l7ssha/prac_inz/document/praca_v3.tex

\documentclass[12pt,a4paper]{article}

\usepackage{minted}
\usepackage[T1]{fontenc}
\usepackage{url}
\usepackage{color,soul}
\usepackage{caption}
\usepackage{biblatex}
\usepackage{float}
\usepackage{geometry}
\usepackage{times}
\usepackage{titlesec}
\usepackage{ragged2e}
\usepackage{fancyhdr}
\usepackage{pdfpages}
\usepackage{graphicx}
\usepackage{indentfirst}

\graphicspath{ {./images/} }

\AddToHook{cmd/section/before}{\clearpage}

\titleformat*{\section}{\fontsize{14}{10}\bfseries\selectfont\MakeUppercase}
\titleformat*{\subsection}{\fontsize{13}{10}\bfseries\selectfont}

\geometry{
    a4paper,
    left=35mm,
    right=25mm,
    top=25mm,
    bottom=30mm,
}

\pagestyle{fancyplain}
\fancyhf{}
\fancyfoot[R]{\thepage}
\renewcommand{\headrulewidth}{0pt}

\renewcommand{\baselinestretch}{1.5}

\captionsetup[table]{name=Tabela}
\captionsetup[figure]{name=Obrazek}
\renewcommand*\contentsname{Spis treści}
\renewcommand{\listtablename}{Spis tabel}
\renewcommand{\listfigurename}{Spis obrazków, fotografii}

\newfloat{code}{h}{loa}
\captionsetup[code]{name=Program}

\makeatletter
\renewcommand\listoffigures{
    \subsection*{\listfigurename
        \@mkboth{
           \MakeUppercase\listfigurename}{\MakeUppercase\listfigurename}}
    \@starttoc{lof}
}
\renewcommand\listoftables{
    \subsection*{\listtablename
        \@mkboth{
           \listtablename}{\listtablename}}
    \@starttoc{lot}
}
\renewcommand*{\listof}[2]{%
  \@ifundefined{ext@#1}{\float@error{#1}}{%
    \@namedef{l@#1}{\@dottedtocline{1}{1.5em}{2.3em}}%
    \subsection*{#2}% \float@listhead{#2}
    \begingroup\setlength{\parskip}{\z@}%
      \@starttoc{\@nameuse{ext@#1}}%
    \endgroup}
}
\makeatother

\addbibresource{sources.bib}

\title{Konstrukcja stacji pogodowej opartej na mikrokontrolerze ESP32 z interfejsem użytkownika oraz API REST}
\author{Szymon Uglis}

\begin{document}

\justifying

\nocite{*}

\begin{titlepage}
    \includepdf{titlepage}
\end{titlepage}

\tableofcontents{}
\pagebreak

\section{Wstęp}

\subsection{Wprowadzenie}
Dzięki szerokiemu dostępowi do internetu mamy łatwy dostęp do danych pogodowych aktualnych jak i historycznych z całego świata. Istnieje wiele serwisów, programów telewizyjnych, które aktualne dane pogodowe, prognozy pogody prezentują nam w przystępny sposób. Problemem z poleganiem na danych pogodowych z popularnych serwisów jest relatywnie niska dokładność aktualnych warunków pogodowych jak i prognoz pogody. Bowiem serwisy te nie mogą mieć stacji pogodowowych rozstawionych co na przykład kilometr, aby dokładność dla każdego potencjalnego zainteresowana była wysoka. Dlatego polega się w dużym stopniu na ogólnych danych z kilku, bądź kilkunastu stacji w danym regionie, aby wykonać ekstrapolację dla aktualnych warunków pogodowych dla całego regionu. Serwisy udostępniające dane pogodowe dla lokalizacji są tylko przybliżeniem faktycznych stanu jaki znajduje sie w danym miejscu.

\subsection{Cel projektu oraz opis tworzonego rozwiązania}

Celem projektu jest zbadanie przydatności modułu ESP32 oraz kompatybilnych komponentów do celów kolekcji danych pogodowych. Rezultatem będzie utworzenie urządzenia opartego na systemie wbudowanym pozwalającym na wielofunkcyjny pomiar parametrów pogodowych oraz udostępnianie ich za pomocą witryny www.

Urządzenie, będzie udostępniało również interfejs programistyczny API REST, które będzie umożliwiało integrację oraz dalszy rozwój projektu (np. integracja z systemem home assistant czy innymi urządzeniami Internetu rzeczy (IoT)).

\subsubsection{Funkcje urządzenia}
\begin{itemize}
    \item Pomiar oraz kalkulacja danych pogodowych na podstawie danych wejściowych z czujników
    \item Udostępnienie i agregacja danych na stronie www
    \item Udostępnienie interfejsu programistycznego REST
    \item Możliwość zmiany parametrów odczytów sensorów
\end{itemize}

\subsubsection{Dostęp zdalny do urządzenia}

Urządzenia ze świata IoT są najczęściej urządzeniami lokalnymi - bez publicznego adresu IP i/lub bez możliwości zdalnego dostępu. Ze względu na niską moc takich urządzeń, ubogie oprogramowanie, w które takie urządzenia są wyposażone bardzo często nie zawierają wielu ważnych zabezpieczeń przeciwko potencjalnym atakom. Dodatkowo dane udostępnianie przez urządzenia IoT z bardzo często są danymi które nie powinny być dostępne publicznie (np. dane o obecności osób w pomieszczeniu lub czy zamek od drzmi jest zamknięty).

Zalecanym jest, aby dostęp do urządzeń IoT był całkowicie lokalny (najlepiej dodatkowo zablokować dostęp do internetu dla tych urządzeń), a zbieraniem i udostępnianiem danych publicznych było realizowane przez oprogramowanie dedykowane do tego celu. Aby umożliwić dostęp do danych zbieranych przez tworzone urządzenie, oprogramowanie będzie implementować możliwość wysyki danych do publicznego brokera MQTT. Dane zaagregowane przez MQTT mogą być dalej bezpiecznie filtrowane, przetwarzane i udostępniane publicznie przez oprogramowanie do tego przystosowane.

\section{Konfiguracja sprzętowa}

\begin{itemize}
    \item Mikrokontroler - ESP-WROOM-32
    \item Czujnik natężenia światła - TSL25911
    \item Czujnik temperatury i wilgotności powietrza - DHT22
    \item Czujnik ciśnienia oraz temperatury - DPS310
    \item Czujnik światła ultrafioletowego - LTR390
\end{itemize}

\begin{figure}[H]
    \centering
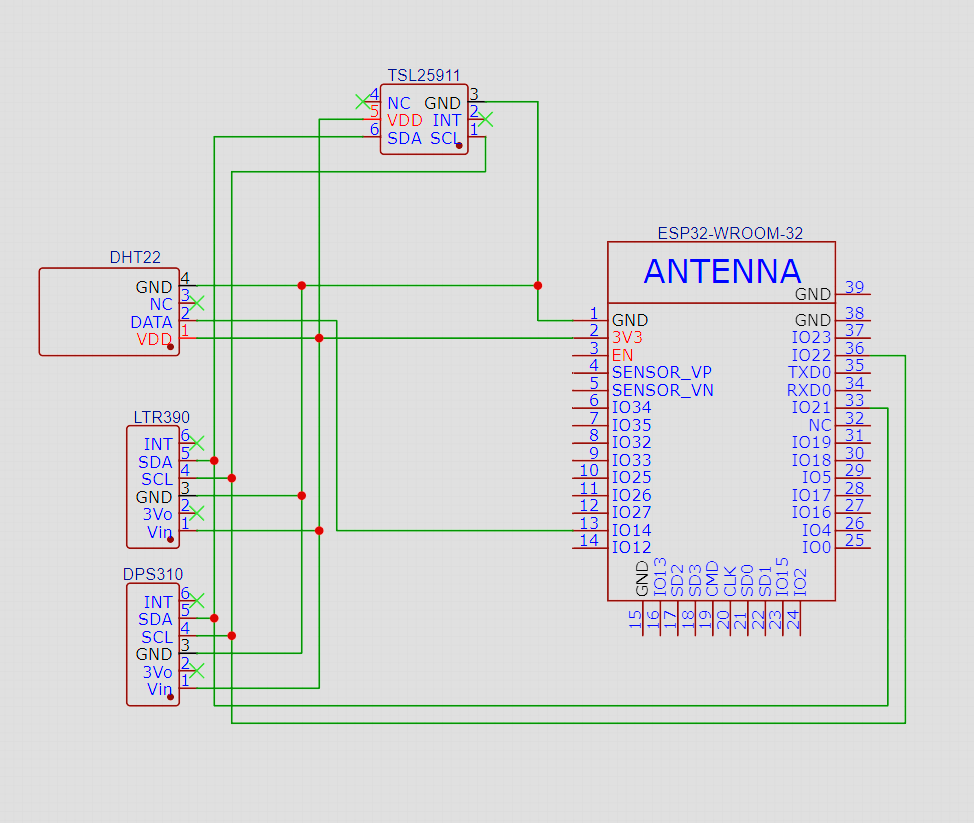
[picture p1: document/images/device-schematic.png]
    
    \caption{Schemat urządzenia}
    \label{device-schematic}
\end{figure}

\begin{figure}[H]
    \centering
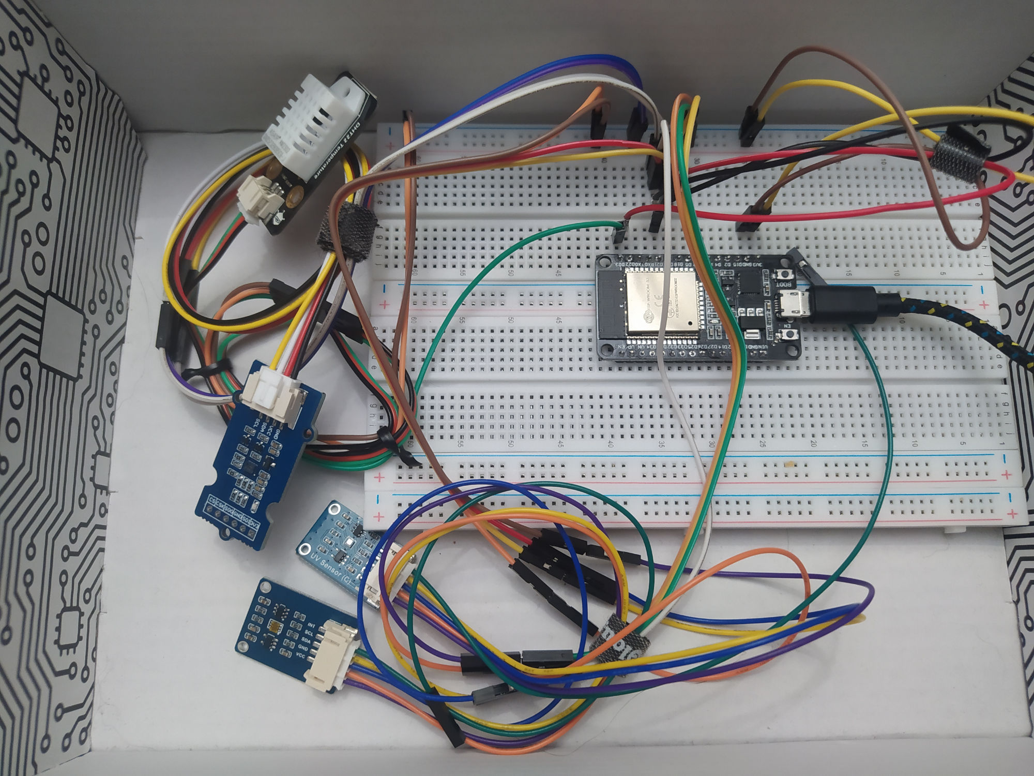
[picture p2: document/images/device-image.jpg]
    
    \caption{Fotografia prototypu urządzenia}
    \label{device-image}
\end{figure}

\subsection{ESP-WROOM-32}
ESP-WROOM-32 (albo ESP32-WROOM-32) to mikrokontroler ze zintegrowanymi interfejsami WIFI oraz bluetooth. Nadaje się do szerokiej gamy zastosowań: od kontrolera czujników z niskim poborem energii do zaawansowanych zadań enkodowania sygnałów głosowych czy muzyki. Moduły bazujące na rdzeniach ESP32 zyskały popularność ze wzlędu na zaintegrowaną obsługę WIFI,  wielu intefejsom oraz niskiemu kosztowi.

Mikrokontroler znajdzie zastosowanie w prostych jak i bardziej skomplikowanych projektach, dzięki dwóm rdzenion, szerokich możliwościach podłączenia urządzeń peryferyjnych (wsparcie dla: I2C, UART, SPI oraz inne).

ESP-WROOM-32 składa się z mikrokontrolera ESP32-D0WDQ6 posiadającego dwa rdzenie, które pozwają na prace z częstotliwościami zegara od 80MHz do 240 MHz. Procesor również posiada koprocesor o niskim poborze mocy, który może zostać użyty zamiast głównych rdzeni w przypadku kiedy nie jest potrzebna duża moc obliczeniowa.

Integracja WIFI, Bluetooth i Bluetooth LE do mikrokontrolera pozwala na rozszerzenie możliwych zastosowań, gdzie nie jest możliwe podłączenie do sieci w konwencjonalny sposób za pomocą kabla. Komunikacja bezprzewodowa również umożliwia całkowicie zdalne zastosowania z wykorzystaniem akumulatorów oraz paneli słonecznych do zasilania mikrokontrolera.

\subsubsection{Specyfikacja ESP-WROOM-32}

\begin{table}[H]
    \centering
    \begin{tabular}{|l|l|}
        \hline
        Element & Specyfikacja \\
        \hline
        Procesor & 2 rdzenie (80-240MHz) \\
        \hline
        WIFI & 802.11 b/g/n (802.11n: przepustowość 150 Mbps) \\
        \hline
        Bluetooth & Bluetooth v4.2 i Bluetooth LE \\
        \hline
        Pamięć SPI Flash & 4MB \\
        \hline
        Napięcie zasilania & 3.0 V - 3.6 V \\
        \hline
        Zużycie prądu & Średnie: 80 mA \\
        \hline
    \end{tabular}
    \caption{Najważniejsze specyfikacje ESP-WROOM-32}
    \label{esp32-spec}
\end{table}

Do realizacji projektu została wybrany mikrokontroler ESP-WROOM-32 ze względu na:
\begin{itemize}
    \item bogate możliwości podłączenia urządzeń peryferyjnych
    \item wbudowane wsparcie połączeń WIFI
    \item dużą ilość pamięci flash
    \item niewielką cenę w porównaniu do oferowanych specyfikacji
    \item łatwą dostępność
\end{itemize}

\noindent Potencjalnymi alternatywami, które nie zostały wybrane do realizacji projektu są:
\begin{itemize}
    \item Arduino Uno R3 (brak wbudowanej obsługi połączeń sieciowych)
    \item ESP8266 (wolniejszy procesor, mniejsza ilość pamięci flash, mniejsza ilość wyprowadzeń do podłączenia urządzeń peryferyjnych)
    \item Olimex ESP32-POE\cite{olimex-esp32poe} (wbudowana obsługa połączenie przewodowego ethernet, mniejsza ilość wyprowadzeń do podłączenia urządzeń peryferyjnych)
    \item LILYGO T-SIM7000G\cite{lilygo-esp32lte} (wbudowana obsługa LTE, mniejsza ilość wyprowadzeń do podłączenia urządzeń peryferyjnych, wysoka cena)
\end{itemize}

\noindent W finalnym produkcie w zależności od przeznaczenia użycie łączności bezprzewodowej może być niemożliwe (daleka odległość od punktu dostępowego WIFI, duża ilość przeszkód). Użycie innych wersji ESP32 z wbudowaną obsługą przewodowego połączenia sieciowego lub możliwością połączenia do sieci przez LTE, może być wymagane - jednak w ramach realizacji zakresu projektu wybór padł na łatwiej dostępny moduł z łącznością bezprzewodową WIFI.  

\subsection{Czujnik natężenia światła - TSL25911}

TSL25911 to czujnik światła z odpowiedzią podobną do ludzkiego oka. Posiada czułość 188 uLux oraz zakres dynamiczny 1 do 600,000,000. W porównaniu do innych tańszych rozwiązań bazujących na fotokomórkach CdS, daje o wiele bardziej precyzyjne rezultaty, z możliwością zmiany czułości i rozdzielczości w locie.

\subsubsection{Specyfikacja TSL25911}
\begin{table}[H]
    \centering
    \begin{tabular}{|l|l|}
        \hline
        Element & Specyfikacja \\
        \hline
        Rozdzielczość dynamiczna & 1 do 600,000,000 \\
        \hline
        Zakres pomiaru & 188 uLux - 88,000 Lux \\
        \hline
        Zakres temperatury pracy & -30 - 80 °C \\
        \hline
        Interfejs & I2C (adres: 0x29 i 0x28)\\
        \hline
    \end{tabular}
    \caption{Specyfikacja TSL25911}
    \label{tsl25911-spec}
\end{table}

\subsubsection{Przykładowy program testu czujnika TSL25911}

\begin{code}[H]
\inputminted[frame=lines,baselinestretch=1,breaklines,linenos,xleftmargin=1.5em]{c}{../proj/tsl2591-test/tsl2591-test.ino}

\caption{Program testu czujnika TSL25911}
\end{code}

\subsubsection{Test czujnika TSL25911}
\begin{figure}[H]
    \centering
    
    \caption{Rezultat testu czujnika TSL25911}
\end{figure}

\subsection{Czujnik temperatury i wilgotności powietrza - DHT22}

Czujnik DHT22 składaja się z dwóch części: pojemnościowego czujnika wilgotności i termistora. Wewnątrz znajduje się również bardzo prosty chip, który dokonuje konwersji sygnału analogowego na cyfrowy i wysyła sygnał cyfrowy z temperaturą i wilgotnością. Sygnał cyfrowy jest łatwy do odczytania za pomocą dowolnego mikrokontrolera.

Czujnik ten cechuje sie bardzo niską ceną oraz bardzo dużą dokładnością w stosunku do ceny.

Potencjalnymi alternatywami, które mogły być wykorzystane to:
\begin{itemize}
    \item DHT11 (niższa dokładność)
    \item AHT20 (niższa dokładność odczytu temperatury oraz podobna dokładność odczytu wilgotności, dostępny tylko jeden adres I2C)
\end{itemize}

Został wybrany DHT11 ze względu na prostotę podłączenia (jedno wyjście cyfrowe) co sprawia, że możliwe jest podłączenie kilku czujników do jednego mikrokontrolera (co nie możliwe jest w przypadku AHT20, bez wykorzystania na przykład drugiego interfejsu I2C). Czujnika DHT22 cechuje się również niskim kosztem oraz wysoką dokładność w stosunku do ceny czujnika, co zadecydowało o finalnym wyborze tego produktu. 

\subsubsection{Specyfikacja DHT22}

\begin{table}[H]
    \centering
    \begin{tabular}{|l|l|}
        \hline
        Element & Specyfikacja \\
        \hline
        Zakres oraz dokładność odczytu temperatury & -40 to 80 °C (dokładność: 0.5°C) \\
        \hline
        Zakres oraz dokładność odczytu wilgotności & 0 to 100 RH\% (dokładność: 2-5 \%) \\
        \hline
        Maksymalna częstotliwość odczytu danych & 0.5Hz \\
        \hline
        Interfejs & One Wire (jeden przewód) \\
        \hline
    \end{tabular}
    \caption{Specyfikacja DHT22}
    \label{dht22-spec}
\end{table}

\subsubsection{Przykładowy program testu czujnika DHT22}

\begin{code}[H]
\inputminted[frame=lines,baselinestretch=1,breaklines,linenos,xleftmargin=1.5em]{c}{../proj/dht22-test/dht22-test.ino}

\caption{Test czujnika DHT22}
\end{code}

\subsubsection{Test czujnika DHT22}
\begin{figure}[H]
    \centering
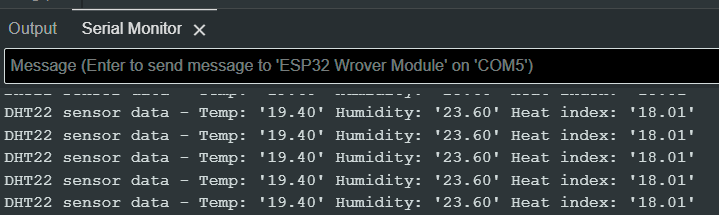
[picture p3: document/images/dht22-test.png]
    
    \caption{Rezultat testu czujnika DHT22}
\end{figure}

\subsection{Czujnik ciśnienia oraz temperatury - DPS310}

Czujnik DP310 służy do dokładnego pomiaru ciśnienia atmosferycznego oraz posiada dodatkowy czujnik temperatury. Posiada wysoką dokładność obsolutną +-1 hPa oraz pracuje w zakresie od 300 do 1200 hPa. Czujnik cechuje sie niską ceną, wysoką dokładnością w stosunku do ceny, oraz posiada dodatkowy czujnik temperatury, który może służyć jako preferowana metoda pomiaru temperatury, albo jako dodatkowy punkt w danych pomiarowych.

Potencjalnymi alternatywami, które mogły być wykorzystane to:
\begin{itemize}
    \item EE895 (niższa dokładność pomiaru ciśnienia (700-1100 hPa, wysoka cena ze względu na obecność czujnika C02))
    \item BMP180 (niższa dokładność pomiaru ciśnienia)
\end{itemize}

Czujnik został wybrany z powodu konkurencyjnej ceny, dużej dostępności oraz wysokiej dokładności pomiaru w stosunku do ceny produktu.

\subsubsection{Specyfikacja DPS310}

\begin{table}[H]
    \centering
    \begin{tabular}{|l|l|}
        \hline
        Element & Specyfikacja \\
        \hline
        Zakres oraz dokładność odczytu temperatury & -40 to 85 °C (dokładność: 1°C) \\
        \hline
        Zakres odczytu ciśnienia atmosferycznego & 300 do 1200 hPa \\
        \hline
        Dokładność absolutna odczytu ciśnienia atmosferycznego & 1 hPa \\
        \hline
        Dokładność dynamiczna odczytu ciśnienia atmosferycznego & 0.002 hPa \\
        \hline
        Interfejs & I2C (domyślny adres: 0x77) \\
        \hline
    \end{tabular}
    \caption{Specyfikacja DPS310}
    \label{dps310-spec}
\end{table}

\subsubsection{Przykładowy program testu czujnika DPS310}

\begin{code}[H]
\inputminted[frame=lines,baselinestretch=1,breaklines,linenos,xleftmargin=1.5em]{c}{../proj/dps310-test/dps310-test.ino}

\caption{Test czujnika DPS310}
\end{code}

\subsubsection{Test czujnika DPS310}
\begin{figure}[H]
    \centering
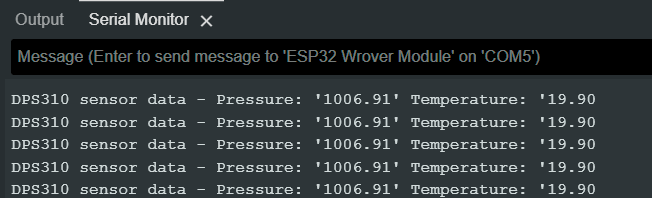
[picture p4: document/images/dps310-test.png]
    
    \caption{Rezultat testu czujnika DPS310}
\end{figure}

\subsection{Czujnik światła ultrafioletowego - LTR390}

Czujnik LTR390 jest urządzeniem o bardzo niskim koszcie oraz wysokiej dokładności na światło w zakresie od 300nm do 350 nm. Czujnik posiada dwa sensory - jeden do światła UV, drugi do światła widzialnego co pozwala na precyzyjne określenie ilości padającego na czujnik światła UV. W porównaniu do innych czujników oferuje bezpośredni odczyt wartości światła UV z sensora (czujnik SI1145 oblicza ilość światła UV z całkowitego odczytu padającego światłą we wszystkich zakresach) oraz pozwala na odczyt danych za pomocą interfejsu I2C (bez konieczności posiadania interfejsów SPI czy posiadania dodatkowych konwerterów analogowo-cyfrowych).

Potencjalnymi alternatywami, które mogły być wykorzystane to:
\begin{itemize}
    \item SI1145 (niższa dokładność pomiaru światła UV - brak bezpośredniego odczytu - wartość obliczana)
    \item GUVA-S12SD (wymagany konwerter analogow-cyfrowy do odczytu danych)
\end{itemize}

Czujnik został wybrany z powodu wysokiej dokładności (bezpośredni odczyt wartości padającego światła UV) oraz prostoty podłączenia czujnika do mikrokontrolera (interfejs I2C). Bardzo niska cena oraz możliwość odczytu natężenia światła (w lux) jest dodatkowym plusem.

\subsubsection{Specyfikacja LTR390}

\begin{table}[H]
    \centering
    \begin{tabular}{|l|l|}
        \hline
        Element & Specyfikacja \\
        \hline
        Zakres odczytu światła UV & od 300nm do 350nm \\
        \hline
        Zakres odczytu światła widzialnego & od 0 do 524287 (20 bitowy zakres) \\
        \hline
        Interfejs & I2C (adres: 0x53) \\
        \hline
    \end{tabular}
    \caption{Specyfikacja LTR390}
    \label{ltr390-spec}
\end{table}

\subsubsection{Przykładowy program testu czujnika LTR390}
\begin{code}[H]
\inputminted[frame=lines,baselinestretch=1,breaklines,linenos,xleftmargin=1.5em]{c}{../proj/ltr390-test/ltr390-test.ino}

\caption{Test czujnika LTR390}
\end{code}

\subsubsection{Test czujnika LTR390}
\begin{figure}[H]
    \centering
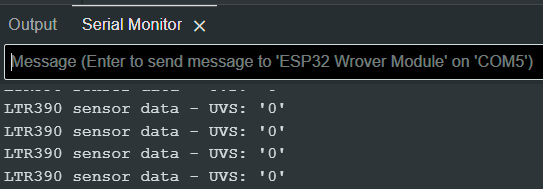
[picture p5: document/images/ltr390-test.png]
    
    \caption{Rezultat testu czujnika LTR390}
\end{figure}

\section{Środowisko programowe}
Do implementacji systemu wbudowanego wykorzystane zostaną:
\begin{itemize}
    \item Język C++ do utworzenia oprogramowania mikrokontrolera
    \item Język HTML oraz CSS do utworzenia interfejsu www
    \item Środowisko programistyczne Arduino Studio w wersji 2.2.1
\end{itemize}

\section{Oprogramowanie}

Do implementacji serwera http została użyta biblioteka ESP32 HTTPS Server \cite{esp32-https-server-library}. 

\begin{code}[H]
\begin{minted}[frame=lines,baselinestretch=1,breaklines,linenos,xleftmargin=1.5em]{c}
#include <HTTPServer.hpp>
#include <HTTPRequest.hpp>
#include <HTTPResponse.hpp>

httpsserver::HTTPServer http_server = httpsserver::HTTPServer();

void handle_api_request(httpsserver::HTTPRequest *req, httpsserver::HTTPResponse *res);
void handle_root_request(httpsserver::HTTPRequest *req, httpsserver::HTTPResponse *res);

void setup(void)
{
    httpsserver::ResourceNode *nodeRoot = new httpsserver::ResourceNode(
        "/", 
        "GET", 
        &handle_root_request
    );
    httpsserver::ResourceNode *nodeApi = new httpsserver::ResourceNode(
        "/api", 
        "GET", 
        &handle_api_request
    );
    http_server.registerNode(nodeRoot);
    http_server.registerNode(nodeApi);
    http_server.start();
    if (http_server.isRunning()) {
        Serial.println("Server ready.");
    }
}

void loop(void)
{
    http_server.loop();
}
\end{minted}
\caption{Wycinek kodu konfigurującego serwer http}
\label{http-server-code-parts}
\end{code}

Biblioteka ta pozwala na proste definiowanie adresów podstron, wraz z przyjmowanym typem zapytania http. Gdy serwer odbierze połączenie od klienta z prawidłowym adresem, wykonuje metode zarejestrowaną w obiekcie serwera, w przeciwnym wypadku zwraca odpowiedź z kodem  \texttt{404 Not Found}.

\subsection{Dostęp do danych przez przeglądarkę}

Urządzenie udostępnia stronę www z odczytami czujników w prostym dla odczytu przez człowieka formacie. Przy pomocy HTML oraz CSS prezentowana jest tabela ze wszystkimi danymi, które udostępnia urządzenie, informacja jaki czas temu dane były aktualizowane oraz jak długo urządzenie pracuje.

Aktualne dane zebrane przez urządzenie są wstrzykiwane do szablonu http za pomocą funkcji sprintf. W pierwszym parametrze podana jest zmienna do bufora, w drugim zmienna z szablonem html a reszta parametrów to poszczególne dane, które mają być wstrzyknięte. Następnie gotowy plik html jest wysyłany do użytkownika.

\begin{code}[H]
\begin{minted}[frame=lines,baselinestretch=1,breaklines,linenos,xleftmargin=1.5em,samepage]{c}
void handle_root_request(
    httpsserver::HTTPRequest *req, 
    httpsserver::HTTPResponse *res
) {
    res->setHeader("Content-Type", "text/html");

    char buffer[2000];
    sprintf(
        buffer, 
        html_template,
        mdns_hostname,
        mdns_hostname,
        current_reading_data.temperature,
        current_reading_data.humidity,
        current_reading_data.heat_index,
        current_reading_data.visible_light,
        current_reading_data.full_spectrum_light,
        current_reading_data.infrared_light,
        current_reading_data.calculated_lux,
        current_reading_data.pressure,
        current_reading_data.uvs,
        sensor_read_delay,
        calculate_uptime()
    );

    res->print(buffer);
}
\end{minted}
\caption{Kod obsługujący interfejs użytkownika}
\label{user-interface-code}
\end{code}

Szablon pliku html jest przechowywany w pamięci programowej programu w stałej \texttt{html\_template}. Zaletą takiego rozwiązania jest prostota implementacji oraz szybkość działania - dane są zawsze gotowe do wykorzystania. Alternatywnie można byłoby wykorzystać pamięć SPIFFS urządzenia do przechowywania szablonu html - byłoby to bardziej elastyczne rozwiązanie, które nie wymagało by ponownej kompilacji programu, aby zmienić szablon html. Z drugiej strony rozwiązanie to mogłoby powodować zwiększony narzut przy generowaniu odpowiedzi przy każdym zapytaniu. Ze względu na prostotę pierwszego rozwiązania oraz potencjalne problemy z wydajnością drugiego rozwiązania zdecydowałem sie załadować szablon do kodu programu w tej wersji oprogramowania. Do deklaracji zawartości zmiennej jest użyta deklaracja jako literał ciągu znaków (string literal), aby w prosty sposób było możliwe zawarcie w środku zmiennej znaków specjalnych, znaków niedozwolonych oraz w celu udostępnienia możliwości deklaracji wieloliniowego ciągu znaków.

\begin{code}[H]
\begin{minted}[frame=lines,baselinestretch=1,breaklines,linenos,xleftmargin=1.5em]{c}
const char html_template[] = R"###(
    <html lang="en">
    <head>
    ...
)###";
\end{minted}
\caption{Kod deklaracji szablonu html}
\label{html-template-code}
\end{code}

Przyszłym usprawnieniem urządzenia mogłoby być sprawdzanie przydatności pamięci SPIFFS do przechowywania szablonów html, aby oszczędzić na pamięci programowej.

\subsubsection{Testy interfejsu WWW}

Interfejs WWW użytkownika zawiera komplet danych zbieranych przez urządzenie oraz kiedy ostatni raz dane były aktualizowane. Odświeżenie przeglądarki spowoduje pobranie nowych danych z urządzenia.
\begin{figure}[H]
    \centering
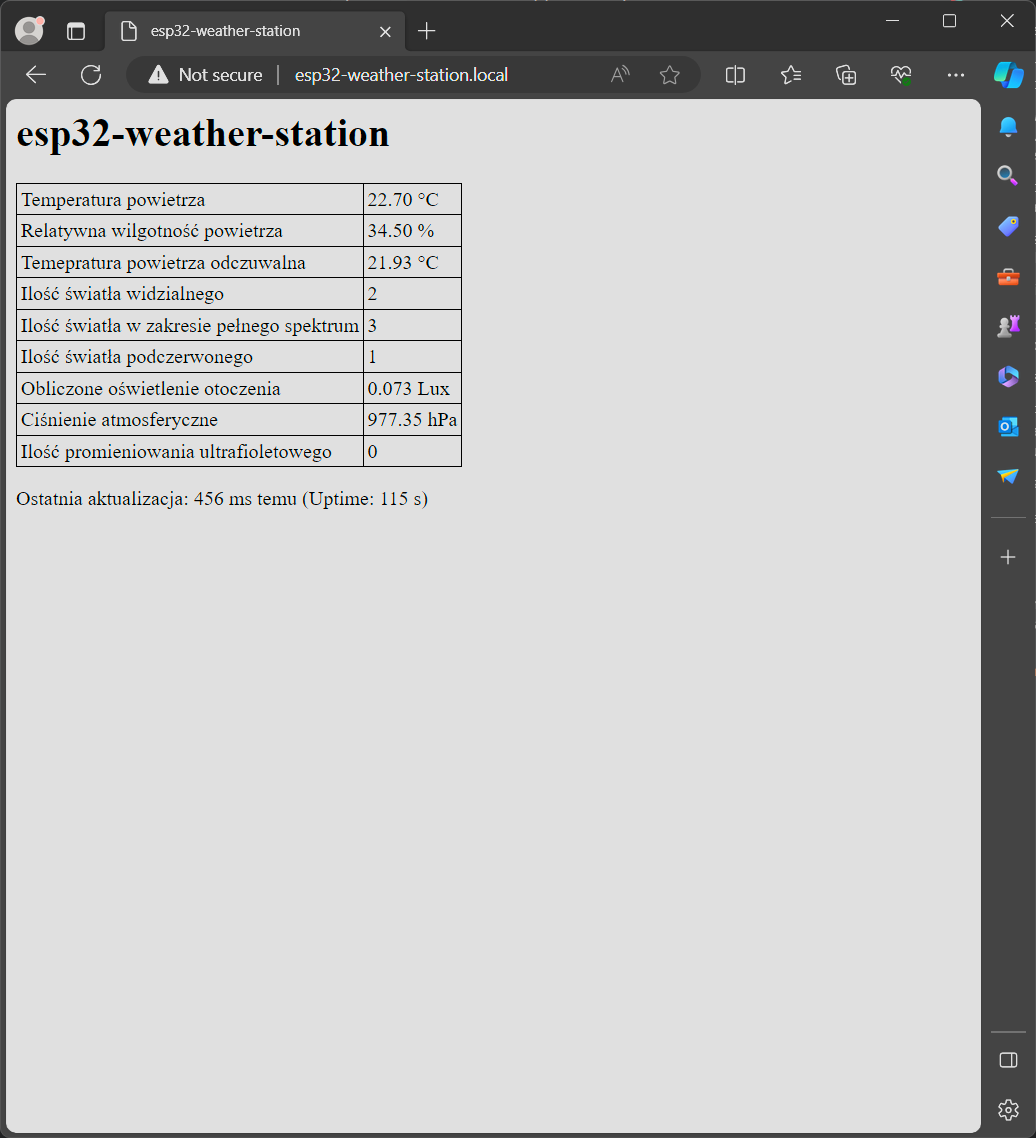
[picture p6: document/photos/web-interface.png]
    
    \caption{Test interfejsu WWW}
\end{figure}

\subsection{Dostęp do danych przez REST API}

Urządzenie udostępnia dane również poprzez interfejs REST API w postaci JSON - umożliwia to łatwą integrację urządzenia z innymi narzędziami, albo umożliwia stworzenie własnych integracji.

\subsubsection{Testy REST API}
\begin{figure}[H]
    \centering
    
    \caption{Test interfejsu REST API}
\end{figure}

\subsection{Dostęp do danych diagnostycznych}

Urządzenie udostępnia dane, które mogą służyć do debugowania urządzenia za pomocą interfejsu szeregowego. Podczas procesu uruchamiania na port szeregowy wysyłane są dane informujące o przebiegu procesu uruchamiania urządzenia, połączeniu do sieci bezprzewodowej oraz po poprawnym uruchomieniu, aktualnie zebrane dane pogodowe.

Funkcja \texttt{send\_debug\_info\_to\_serial} wysyła dane na interfejs szeregowy w postaci łatwej do przeczytania dla człowieka:

\begin{code}[H]
\begin{minted}[frame=lines,baselinestretch=1,breaklines,linenos,xleftmargin=1.5em]{c}
void send_debug_info_to_serial()
{
    Serial.print(F("DHT22 sensor data - Temp: '"));
    Serial.print(current_reading_data.temperature);
    Serial.print(F("' Humidity: '"));
    Serial.print(current_reading_data.humidity);
    Serial.print(F("' Heat index: '"));
    Serial.print(current_reading_data.heat_index);
    Serial.println(F("'"));

    Serial.print(F("TSL2591 sensor data - Calculated Lux: '"));
    Serial.print(current_reading_data.calculated_lux);
    Serial.print(F("' Full spectrum light: '"));
    Serial.print(current_reading_data.full_spectrum_light);
    Serial.print(F("' Infrared light: '"));
    Serial.print(current_reading_data.infrared_light);
    Serial.print(F("' Visible light: '"));
    Serial.print(current_reading_data.visible_light);
    Serial.println(F("'"));

    Serial.print(F("DPS310 sensor data - Pressure: '"));
    Serial.print(current_reading_data.pressure);
    Serial.println(F("hPa'"));

    Serial.print(F("LTR390 sensor data - UVS: '"));
    Serial.print(current_reading_data.uvs);
    Serial.println(F("'"));

    Serial.println(F(""));
}
\end{minted}
\caption{Kod dostępu do danych diagnostycznych}
\label{diagnostic-data-code}
\end{code}

Jako, że powyższa funkcja operuje na dużej ilość tekstu w sposób cały, zostało zastosowana optymalizacja w postaci użycia funkcji 
\texttt{F} - funkcja ta sprawia, że dany łańcuch znaków nie jest kopiowany do pamięci PSRAM mikrokontrolera przed wysłaniem na interfejs szeregowy, a dane są bezpośrednio kopiowane z programu do strumienia, który wysyłane dane na interfejs.

\subsection{Test danych diagnostycznych}

To przeprowadzenia testy zostało użyte narządzie Serial Monitor z Arduino Studio. Mikrokontroler wysyła dane na port szeregowy w prędkości 115200 baud.

\begin{figure}[H]
    \centering
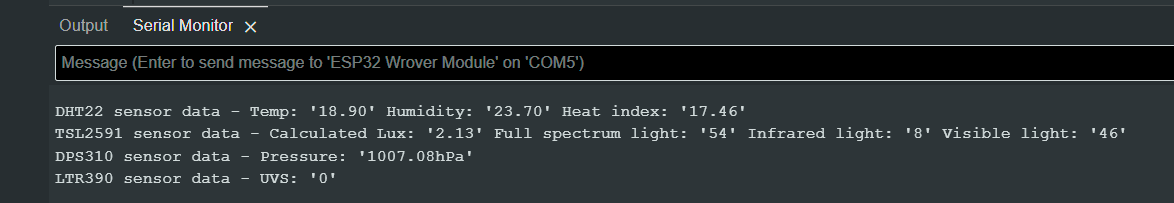
[picture p7: document/images/diagnostic-data.png]
    
    \caption{Test danych diagnostycznych}
\end{figure}

\subsection{Integracja z MQTT}

Urządzenie dodatkowo udostępnia możliwość połączenia do brokera MQTT - co umożliwia bezpieczne udostępniane danych do serwera zewnętrznego.

MQTT to prosty oraz lekki protokół wymiany danych oparty o wzorzec publikacja/subskrypcja. Przeznaczony do zastosowań nie wymagających dużej przepustowości. Ze względu na prostotę oraz lekkość jest bardzo niezawodny oraz niewymagający skomplikowanej implementacji co czyni go idealnym dla zastosowań Internetu Rzeczy.

Do implementacji połączenia do serwera MQTT użyta została biblioteka \texttt{EspMQTTClient}\cite{esp32-mqtt-server-library} - 
która zarządza połączeniem do serwera oraz wymianą danych między klientem oraz serwerem. Poniższy kod umożliwia podłączenie urządzenia do lokalnego albo zewnętrznego serwera MQTT:
\begin{code}[H]
\begin{minted}[frame=lines,baselinestretch=1,breaklines,linenos,xleftmargin=1.5em]{c}
EspMQTTClient mqtt_client(
    "192.168.0.15", // host
    1883, // port
    "username", // username
    "password", // password
    mdns_hostname // device name
);
\end{minted}
\caption{Kod umozliwiajacy połączenie do serwera MQTT}
\label{diagnostic-data-code}
\end{code}

Do wysyłki danych do brokera MQTT potrzebny jest temat, na który informacja ma być wysłana oraz
sama dana w formacie \texttt{String} - ciągu znaków. W przykładzie zmienna z typem \texttt{float} zmieniania jest na ciąg znaków \texttt{String}:
\begin{code}[H]
\begin{minted}[frame=lines,baselinestretch=1,breaklines,linenos,xleftmargin=1.5em]{c}
void send_data_to_mqtt()
{
    String topic = "homeassistant/sensor/esp32-weather-station/temperature";
    mqtt_client.publish(topic, float_to_string(current_reading_data.temperature));
}
\end{minted}
\caption{Wycinek kodu wysyłający dane do brokera MQTT}
\label{mqtt-data-send}
\end{code}

\subsubsection{Testy połączenia MQTT}
Możliwe jest połączenie sie do lokalnego serwera MQTT jeżeli urządzenie przetwarza danych delikatne lub dane mogą zostać wysyłane do publicznego serwera MQTT, co pozwoli na zdalny dostęp do danych, spoza sieci lokalnej.
\begin{figure}[H]
    \centering
    
    \caption{Test integracji z MQTT z serwerem lokalnym}
\end{figure}

\begin{figure}[H]
    \centering
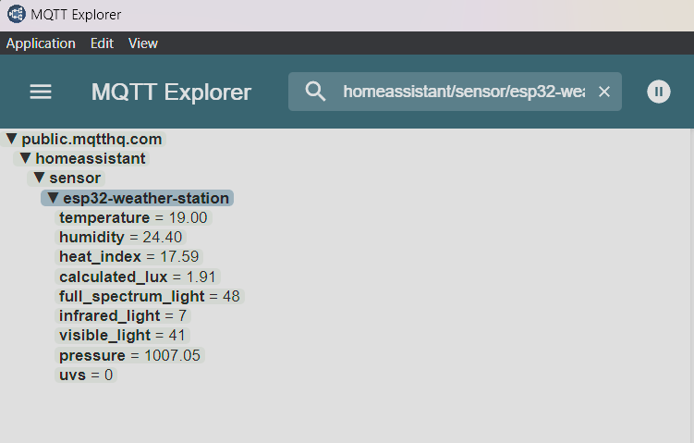
[picture p8: document/images/mqtt-public.png]
    
    \caption{Test integracji z MQTT z serwerem publicznym}
\end{figure}

Do podejrzenia danych przesyłanych na serwer MQTT został użyty program MQTT Explorer - jest to darmowy program pełniący rolę klienta MQTT, pozwalający na odczyt danych z tematów serwera MQTT oraz na nadawanie nowych wiadomości w zadanym temacie. Program jest dostępny na systemy operacyjne Windows, Linux oraz Mac.

\begin{figure}[H]
    \centering
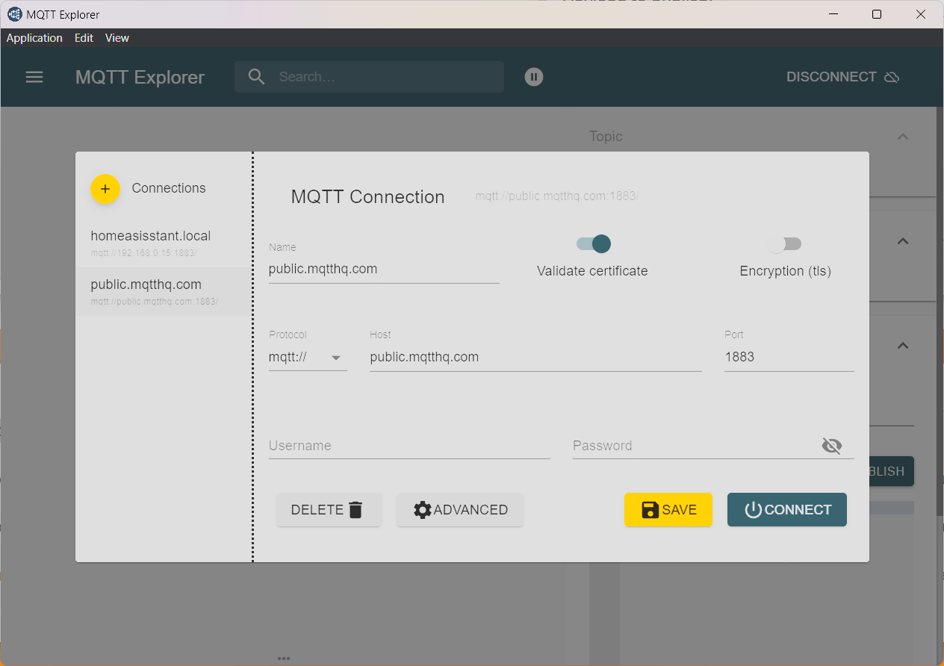
[picture p9: document/images/mqtt-explorer.png]
    
    \caption{MQTT Explorer - podłączenie do serwera mqtthq.com}
\end{figure}

\subsection{Protokół mDNS}

Protokół mDNS służy do rozwiązywania nazw urządzeń sieciowych do adresów IP - dzięki temu użytkownik ma możliwość połączenia z urządzeniem nie znając jego adresu - wystarczy nazwa urządzenia sieciowego. mDNS należy do rodziny protokołów Zeroconf (lub zero-config)\cite{zeroconf-explanation} - nie wymaga konfiguracja do pracy 
i jest protokół ten wspierany przez Windowsa (10+) oraz Linuxa (po instalacji programu Avahi).

W projekcie protokół ten zostanie użyty, aby użytkownik nie musiał znać adresu IP urządzenia, aby sie z nim połączyć. Protokół jest konfigurowany za pomocą pliku nagłówkowego \texttt{ESPmDNS.h}. Aby skonfigurować usługę, aby mikrokontroler był możliwy do odnalezienia w sieci poprzez mDNS należy wystartować serwer mDNS oraz dodać nową usługę usługę z typem (w przykładzie http), protokołem (w przykładzie  \texttt{http}), protokołem (w przykładzie \texttt{tcp}) 
oraz portem pod którym usługa jest dostępna (w przykładzie: \texttt{80} - port serwera www z danymi, które udostępnia urządzenie).

Po prawidłowej konfiguracji oraz wpisaniu adresu \\\texttt{http://esp32-weather-station.local/} w przeglądarce powinna zostać wyświetlona strona www udostępnianą przez mikrokontroler.

\begin{code}[H]
\begin{minted}[frame=lines,baselinestretch=1,breaklines,linenos,xleftmargin=1.5em]{c}
void setup()
{
    // esp32-weather-station.local
    if (!MDNS.begin("esp32-weather-station")) {
        Serial.println("Error setting up MDNS responder!");
        while (1) {
        delay(1000);
        }
    }

    MDNS.addService("http", "tcp", 80);
}
\end{minted}
\caption{Przykład konfiguracji usługi mDNS}
\end{code}

\section[Testy - porównanie z komercyjnymi danymi pogodowymi]{Testy - porównanie z komercyjnymi\\
 danymi pogodowymi}

% \subsection{Porównanie z komercyjnymi danymi pogodowymi}

Dane pogodowe dostarczane przez urządzenie będą bardziej dokładne lokalnie niż prognoza pogody dostępna w komercyjnych serwisach. Obrazek \ref{test-outside-site} wykazuje, że aktualna temperatura wynosi 
\texttt{-3.6°C} a względna wilgotność powietrza wynosi \texttt{73.7\%}. 
Dane udostępniane przez serwis meteo.pl \cite{meteopl-nysa} dla tej samej co lokalizacja urządzenia
wskazuje, że temperatura wynosi 
\texttt{-5°C} a względna wilgotność powietrza wynosi \texttt{85\%}.

\begin{figure}[H]
    \centering
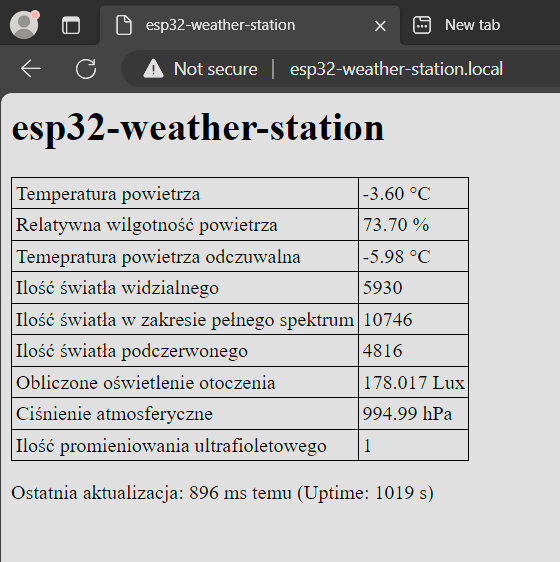
[picture p10: document/images/test-outside-site.png]
    
    \caption{Porównanie danych pogodowych - urządzenie}
    \label{test-outside-site}
\end{figure}

\begin{figure}[H]
    \centering
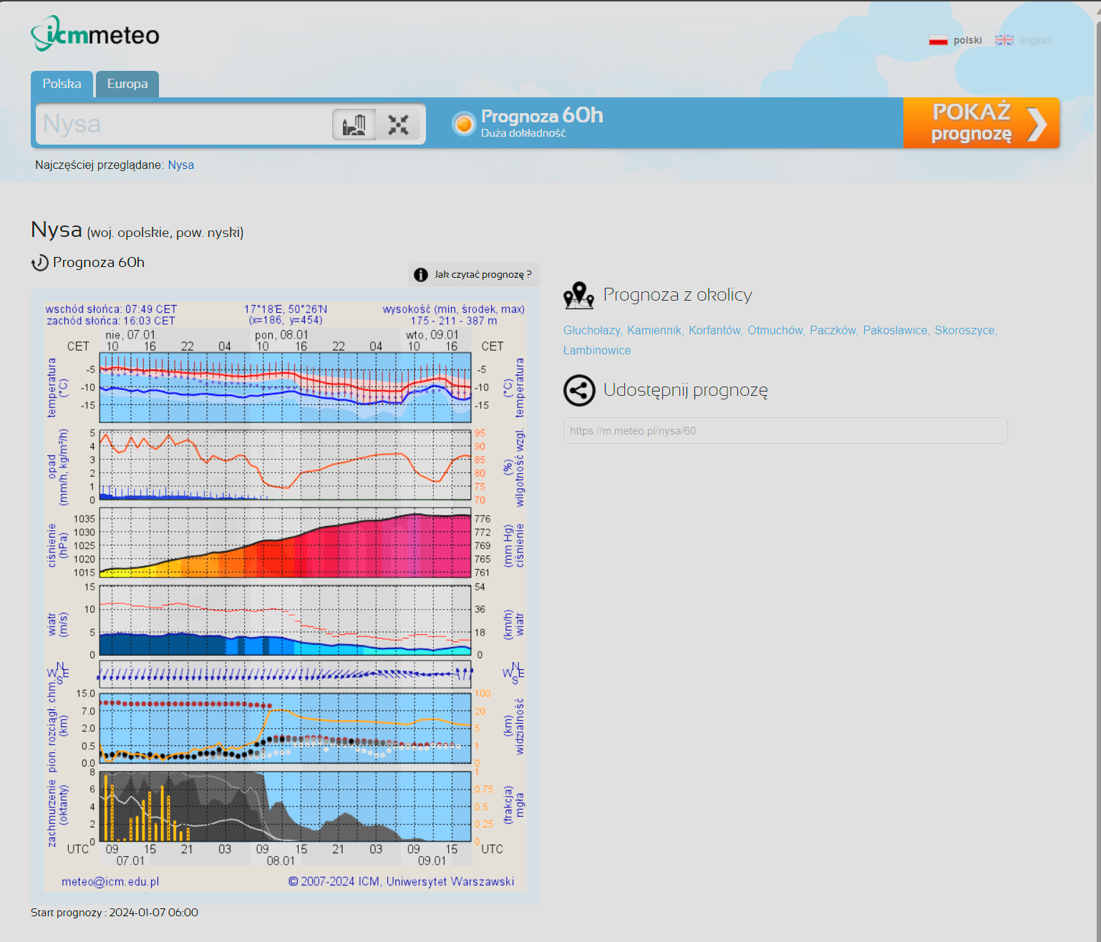
[picture p11: document/images/test-outside-meteo.pl.png]
    
    \caption{Porównanie danych pogodowych - meteo.pl}
    \label{test-outside-meteo}
\end{figure}

% \subsection{Dostęp do danych za pomocą MQTT i Home Assistant}

% Dane przesyłane do MQTT mogą być odczytane przez zewnętrzny serwis w ceu wyświetlenia danych - w tym przypadku jest to aplikacja Home Assistant\cite{homeassistant}. Za pomocą wpisu w konfiguracji w języku
% YAML możliwe jest odczytanie danych z serwera MQTT i wyświetlenie danych tych na panelu. 

% \begin{figure}[H]
%     \centering
%     \includegraphics[width=\textwidth]{home-assistant-weathe-station.png}
%     \caption{Dostęp do danych pogodowych przez Home Assistant}
%     \label{homeassistant-weather-station}
% \end{figure}

\section{Wnioski}
Moduły bazujące na mikrokontrolerze ESP32 pozwalają na łatwą realizację projektów, a przez dużą różnorodność ekosystemu Arduino integracja z innymi wspieranymi komponentami jest prosta oraz daje ogromną wszechstronność w realizacji projektów.

W tej pracy zrealizowana została lokalna stacja pogodowa umożliwiająca odczyt danych pogodowych w sieci lokalnej za pomocą interfejsu WWW, interfejsu REST API. Dostęp do danych spoza sieci lokalnej możliwy jest po podłączeniu do dostępnego publicznie serwera MQTT - urządzenie zostaje bezpośrednio dostępne tylko w sieci lokalnej, a dane mogą zostać pobrane z brokera MQTT (na przykład: mqtthq.com). Lokalny dostęp do urządzenia jest jest bardzo prosty dzięki protokołowi mDNS - aby połączyć się z urządzeniem nie jest potrzebny adres IP, a wystarczy nazwa urządzenia w sieci, która jest statyczna.

Urządzenie zostało uruchomione w środowisko lokalnej sieci LAN - interfejs WWW, interfejs programistyczny dostępne są wyłączenie w sieci lokalnej, a dzięki możliwości połączenia do serwera MQTT możliwe jest odczytanie danych, które zbiera urządzenie poza lokalną siecią. Dane zostały poprawnie odczytane za pomocą interfejsu WWW, przez interfejs programistyczny REST API w formacie JSON oraz zostały poprawnie odczytane z tematu w publicznym brokerze MQTT.

Kolejnym etapem rozwoju projektu mogłaby być kolejna wersja interfejsu użytkownika, dodatkowe integracje z innymi systemami zewnętrznymi lub integracja czujników oraz mikrokontrolera na jednej płytce PCB. Podłączenie kolejnych czujników do urządzenia również nie powinno sprawiać problemu ze względu na dużą dostępność dodatkowych pinów WE/WYJ oraz otwartej natury całego ekosystemuESP32. Kolejnym usprawnieniem projektu mogłoby być przystosowanie urządzenia do uruchomienia bez lokalnej sieci bezprzewodowej - do połączenia z Internetem mogłyby zostać wykorzystane modemy sieci GSM lub LoRa lub połączenie z siecią przewodową (sieć Ethernet).

\section{Literatura}

\printbibliography[heading=none]

\section{Spisy programów, tabel, fotografii}
\listoftables
\listof{code}{Spis programów}
\listoffigures

\section{Streszczenie}
Praca inżynierska podejmuje temat "Konstrukcja stacji pogodowej opartej na mikrokontrolerze ESP32 z interfejsem użytkownika oraz API REST". Głównym celem pracy było przygotowanie prototypu urządzenia stacji pogodowej wraz z oprogramowaniem oraz test przydatności takiego urządzenia do celów domowych. Zaletami lokalnej stacji pogodowej jest wysoka dokładność oraz wysoka przewidywalność odczytów w porównaniu do danych zbieranych przez inne komercyjne serwisy. W ramach pracy został wybrany mikrokontroler ESP32 oraz czujniki wykorzystane w urządzeniu, został skonstruowany prototyp urządzenia bazujący na wybranych komponentatch oraz zostało przygotowane oprogramowanie sterujące pracą mikrokontrolera. Duża różnorodność czujników, wysoka dostępność mikrokontrolerów oraz bogaty ekosystem programowy umożliwia szybką, tanią i prostą konstrukcje urządzeń bazujących na ESP32. Oprogramowanie urządzenia udostępnia interfejs www dla użytkownika, interfejs programowy REST API oraz integracje z brokerem MQTT. Urządzenie zostało uruchomione w środowisko lokalnej sieci LAN - interfejs WWW, interfejs programistyczny dostępne są wyłącznie w sieci lokalnej, a dzięki możliwości połączenia do serwera MQTT możliwe jest odczytanie danych, które zbiera urządzenie poza lokalną siecią. Przyszłymi usprawnieniami projektu mogłyby być integracja z wiekszą ilością czujników, implementacja przewodowego połączenia sieciowego, połączeń GSM lub LoRa oraz usprawnienia w interfejsie użytkownika.

\end{document}
