l7ssha/prac_inz/presentation-prac-inz.pptx

## Praca dyplomowa inyżynierska

Konstrukcja stacji pogodowej opartej na mikrokontrolerze ESP32 z interfejsem użytkownika oraz API REST

Szymon Uglis (16982)
Promotor: dr Jędrzej Ułasiewicz

## Cel pracy (bardziej opisac dlaczego I po co)

- Zbadanie przydatności modułu ESP32 oraz kompatybilnych komponentów do celów kolekcji danych pogodowych
- Konstrukcja urządzenia na bazie ESP32 oraz wybranych komponentów
- Przygotowanie oprogramowania mikrokontrolera
  - Zbieranie danych z czyjników
  - Udostępnienie interfejsu wygodnego dla użytownika
  - Udostępnienie interfejsu programistycznego REST API

## Wybrane komponety urządzenia

- Mikrokontroler ESP32-WROOM-32
- Czujnik natężenia światła - TSL25911
- Czujnik temperatury i wilgotności powietrza - DHT22
- Czujnik ciśnienia oraz temperatury - DPS310
- Czujnik światła ultrafioletowego - LTR390

## Prototyp urządzenia

// TODO: fotografia

## Interfejs użytkownika

// TODO: screenshot

## Interfejs programistyczny (REST API)

// TODO: screenshot

## Schemat blokowy

## Wnioski

- Przygotowana stacja pogodowa pozwala na kolekcjonowanie przydatnych statystyk relatywnie niskim kosztem
- Interfejs programistyczny REST API pozwoli na prostą integrację z zewnętrzymi serwisami
  - Agregacja i przechowywanie danych historycznych w bazie danych
  - Eksport danych do zewnętrznych serwisów
- Prosty interfejs użytkownika pozwalający usyskać komplet danych
