l7ssha/prac_inz/document/titlepage.docx

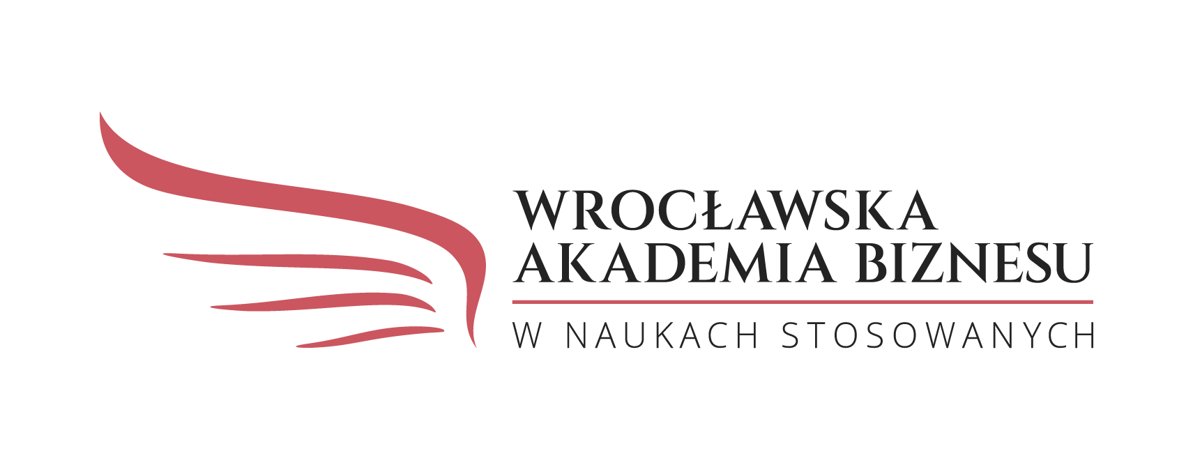
[picture p19: figure]
Obraz zawierający Grafika, projekt graficzny, Czcionka, design Opis wygenerowany automatycznie

KIERUNEK: Informatyka

SPECJALNOŚĆ: Inżynieria oprogramowania

SPECJALIZACJA (na Filologii)

Stacja pogodowa oparta na mikrokontrolerze ESP32 z interfejsem użytkownika WWW oraz REST API

PRACA KWALIFIKACYJNA/PROJEKT INŻYNIERSKI

SZYMON UGLIS NR ALBUMU 16982 | PROMOTOR/WYKŁADOWCA DR JĘDRZEJ UŁASIEWICZ

Przyjmuję pracę i dopuszczam
do egzaminu dyplomowego

(data i podpis promotora)

Wrocław 2024
