l7ssha/prac_inz/document/images/home-assistant-weathe-station.png

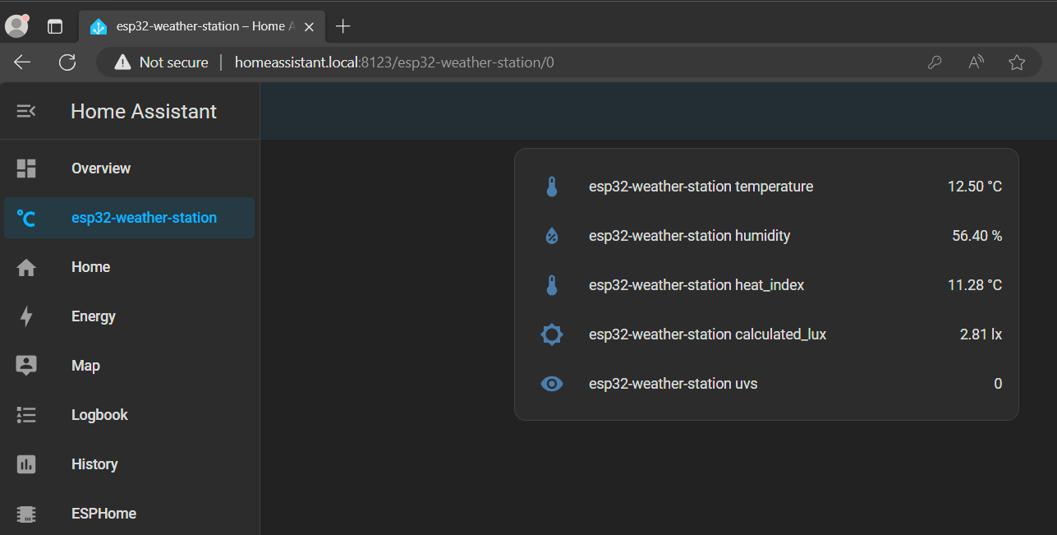
document/images/home-assistant-weathe-station.png
