l7ssha/prac_inz/document/images/Screenshot 2024-01-07 153236.png

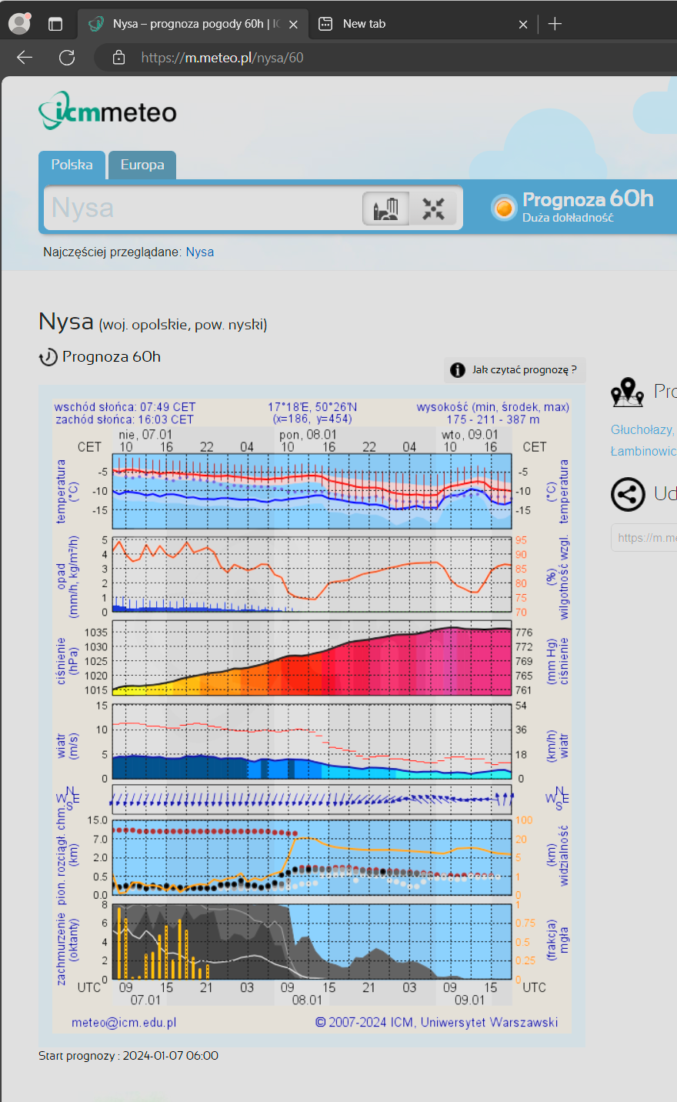
document/images/Screenshot 2024-01-07 153236.png
