l7ssha/prac_inz/photos/Prototype-700297446609.jpg

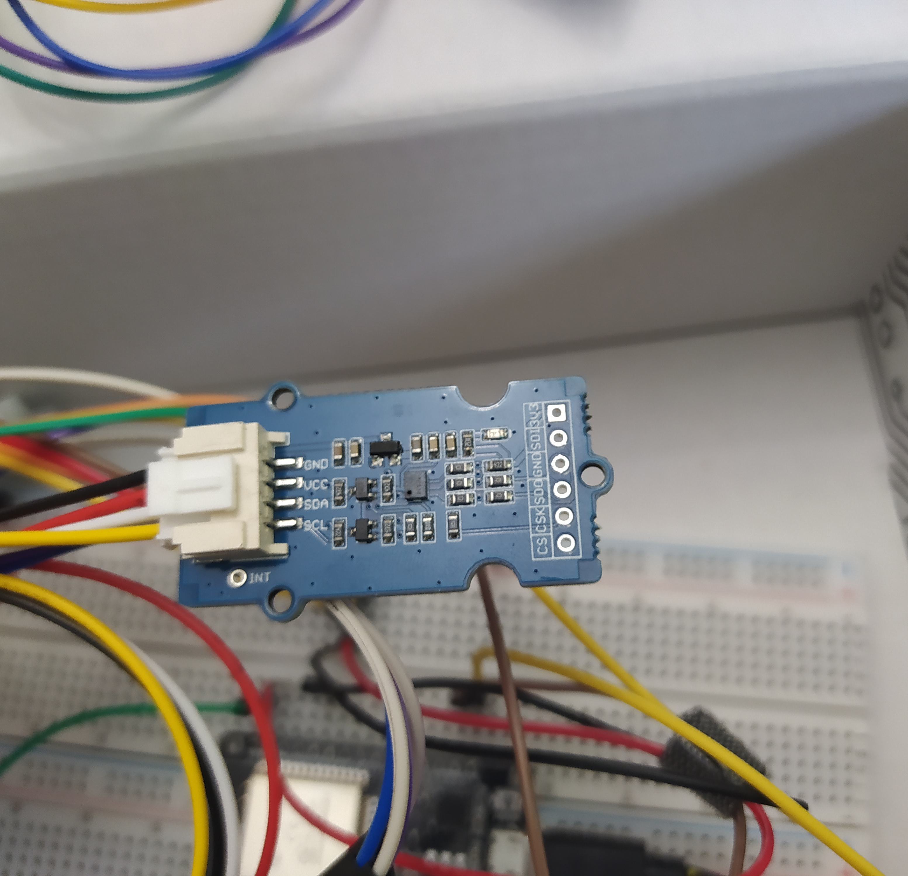
photos/Prototype-700297446609.jpg
