l7ssha/prac_inz/photos/Prototype-700297446635.jpg

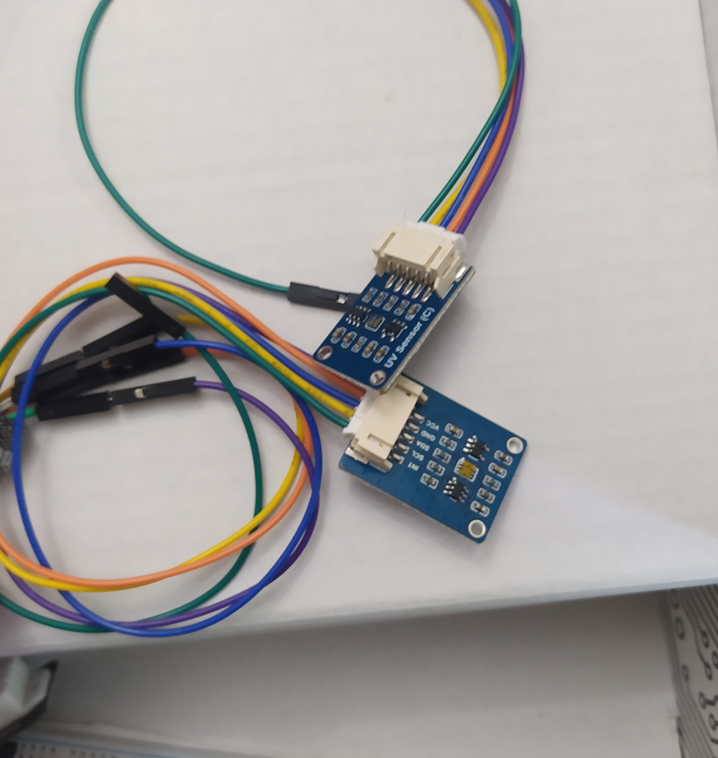
photos/Prototype-700297446635.jpg
