l7ssha/prac_inz/document/images/test-outside-mqtt.png

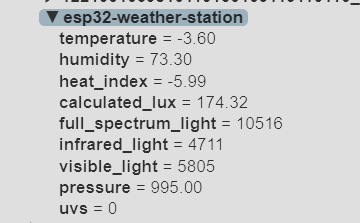
document/images/test-outside-mqtt.png
