l7ssha/prac_inz/(commit log)

2023-11-16 ESP32 firmware initial implementation
2023-11-17 Implement LTR390 sensor
2023-11-27 Add examples for the rest of sensors; Add mDNS section
2023-12-01 Modelowanie Systemów Informatycznych Done
    [gantt.xlsx]
2024-01-04 Add alternatives to ESP32
2024-01-07 Add tests section; Add device schematic
2024-01-09 Add device photo
2024-01-10 Fix document after review
    [dht22-test.ino, dps310-test.ino, ws_firmware.ino]
